umhr/HardwareWatchdogTimer/blog/PXL_20220502_052127613.jpg

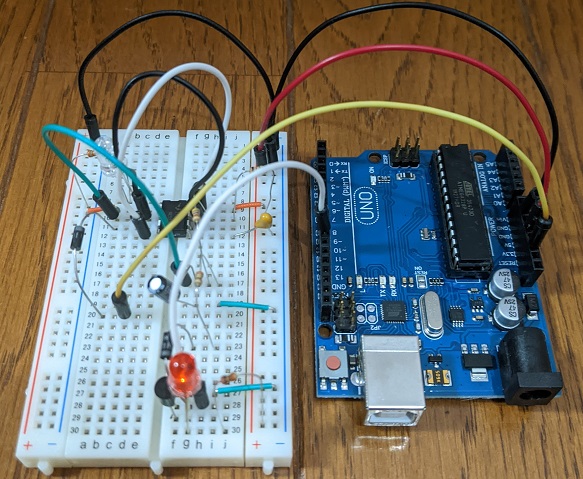
blog/PXL_20220502_052127613.jpg
