umhr/HardwareWatchdogTimer/blog/20220518_112517.png

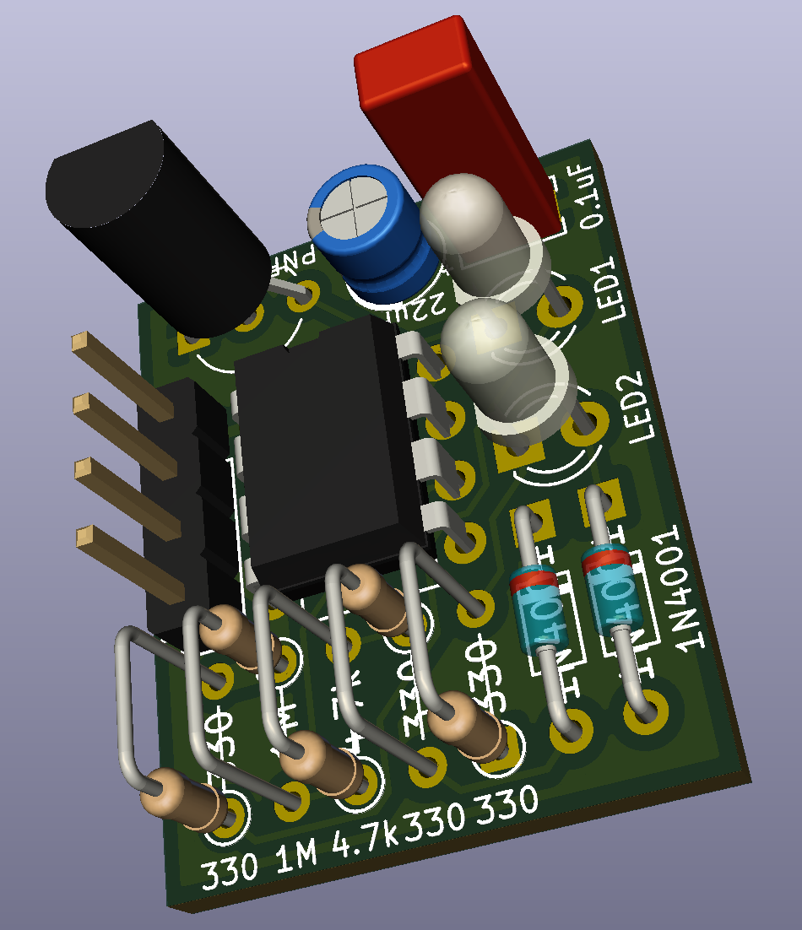
blog/20220518_112517.png
