umhr/HardwareWatchdogTimer/blog/20220518_112225.png

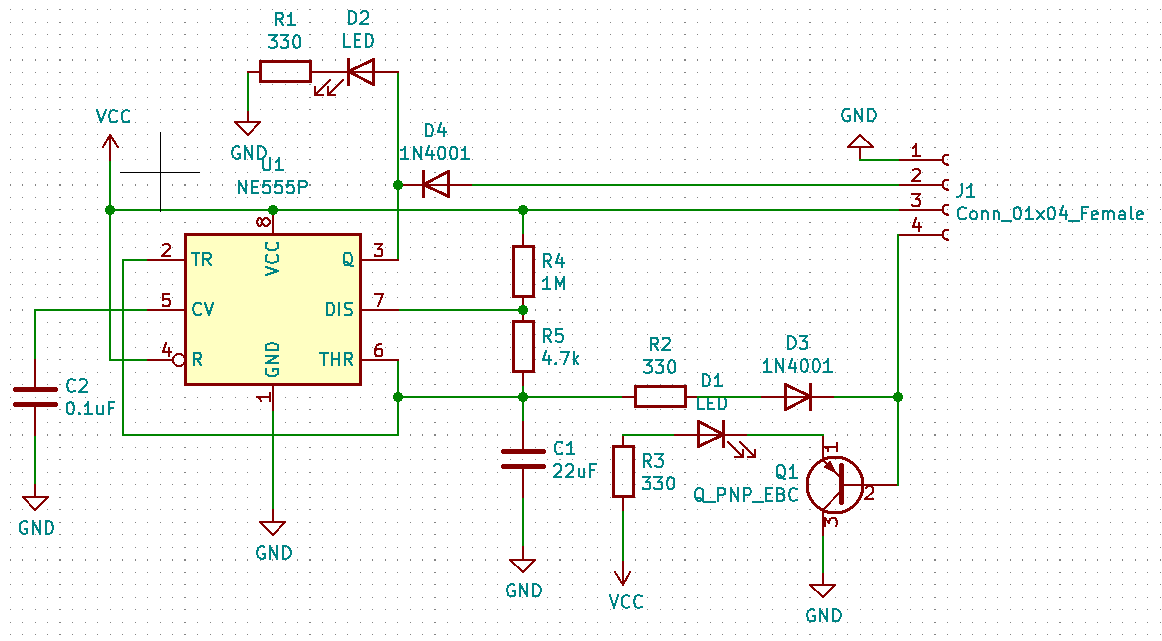
blog/20220518_112225.png
