umhr/HardwareWatchdogTimer/blog/20220518_112425.png

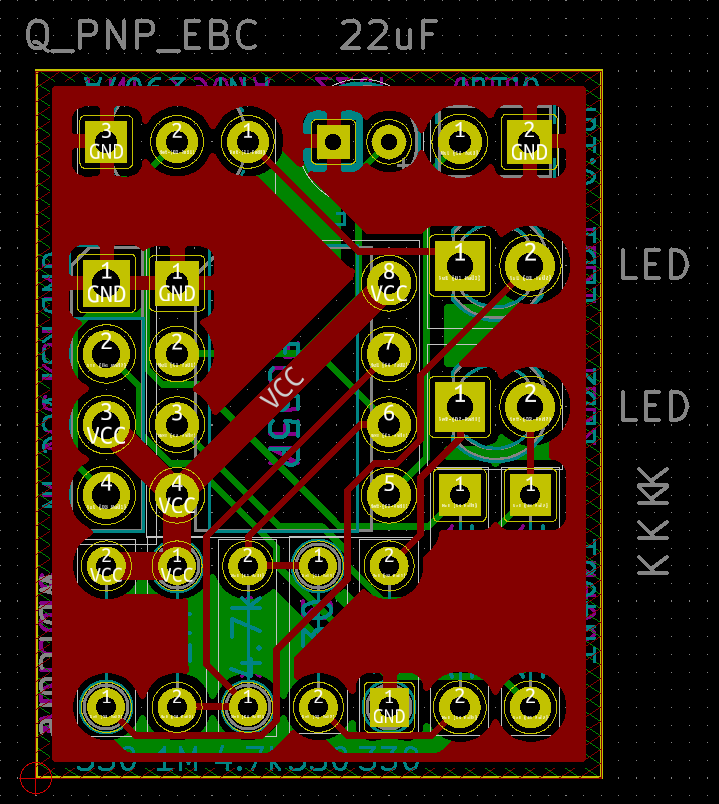
blog/20220518_112425.png
