umhr/HardwareWatchdogTimer/fritzing/wdt_ブレッドボード.png

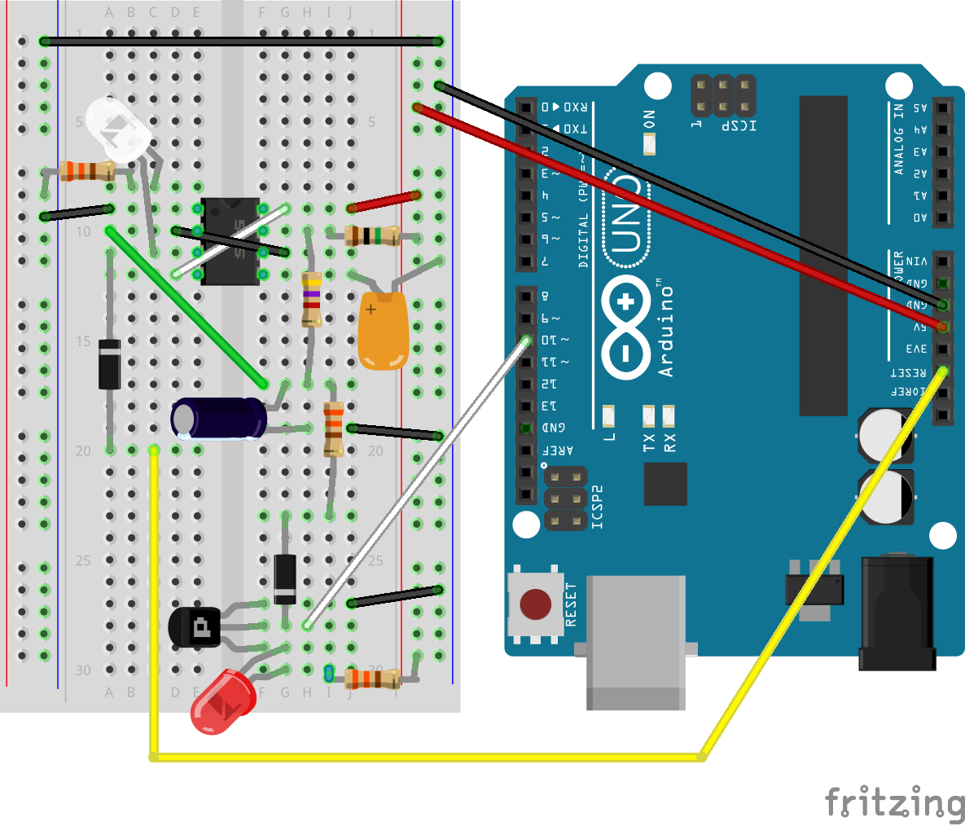
fritzing/wdt_ブレッドボード.png
