umhr/HardwareWatchdogTimer/fritzing/wdt_回路図.png

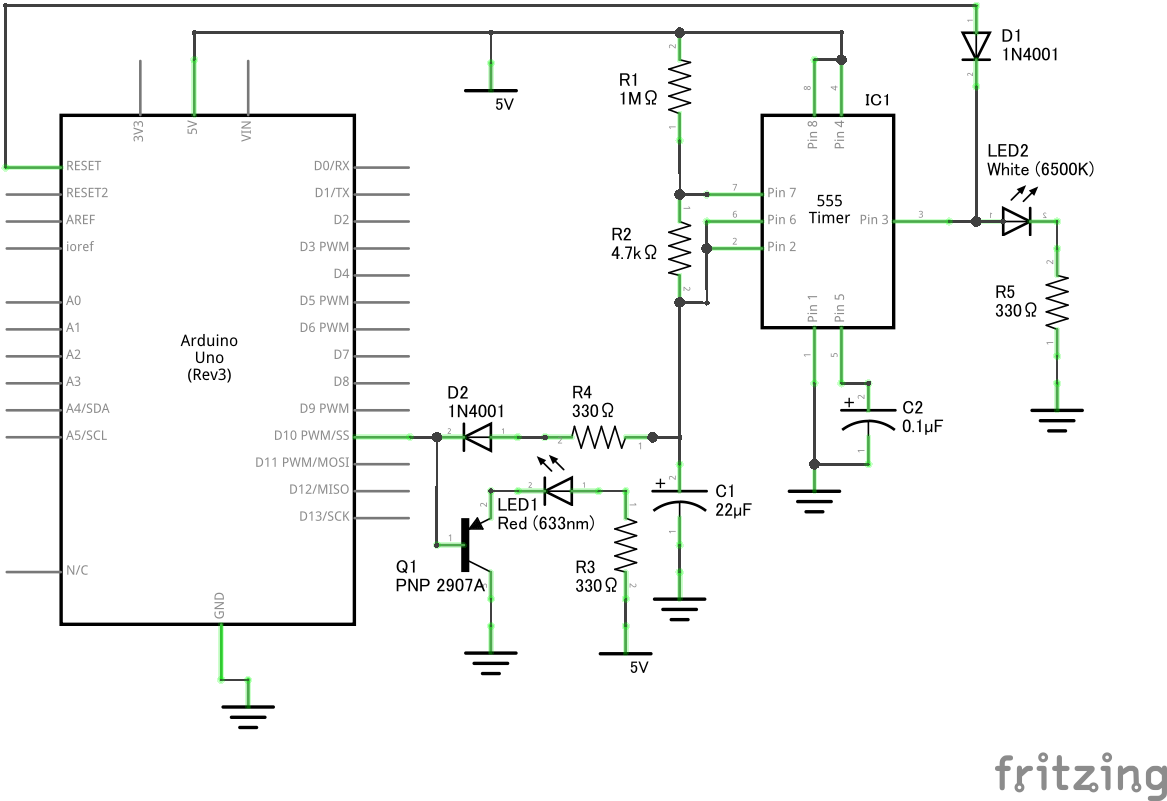
fritzing/wdt_回路図.png
