umhr/HardwareWatchdogTimer/fritzing/wdtmini_ブレッドボード.png

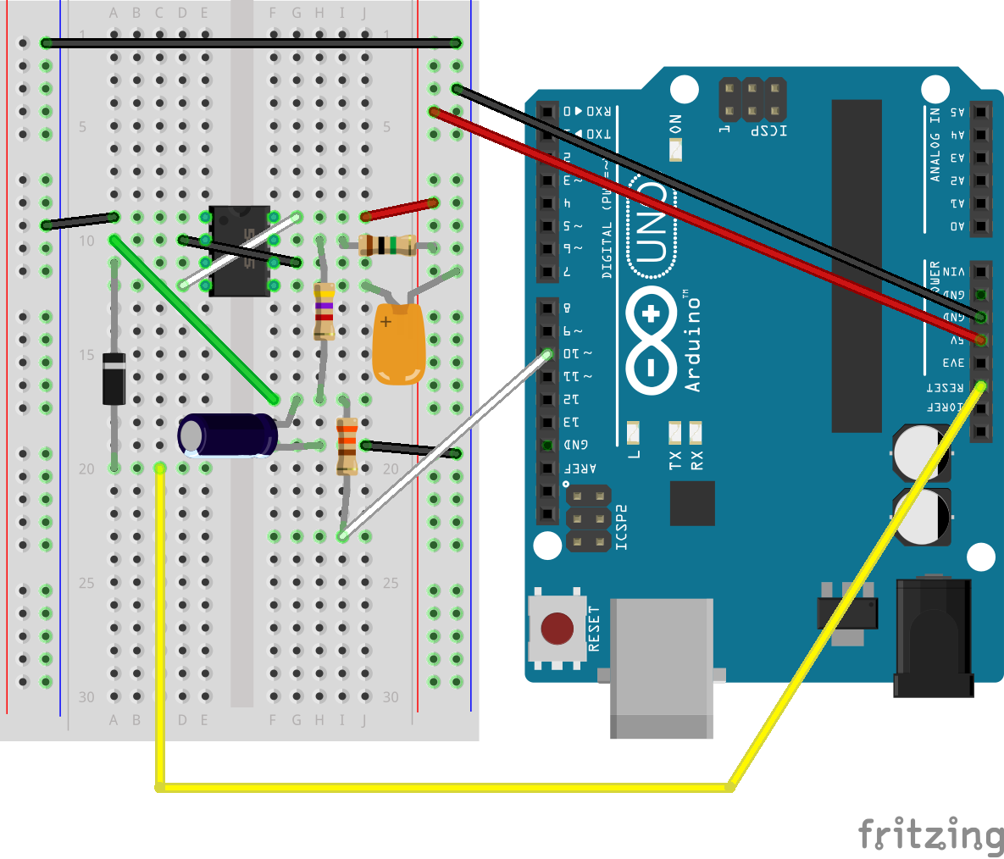
fritzing/wdtmini_ブレッドボード.png
