umhr/HardwareWatchdogTimer/fritzing/wdtmini_回路図.png

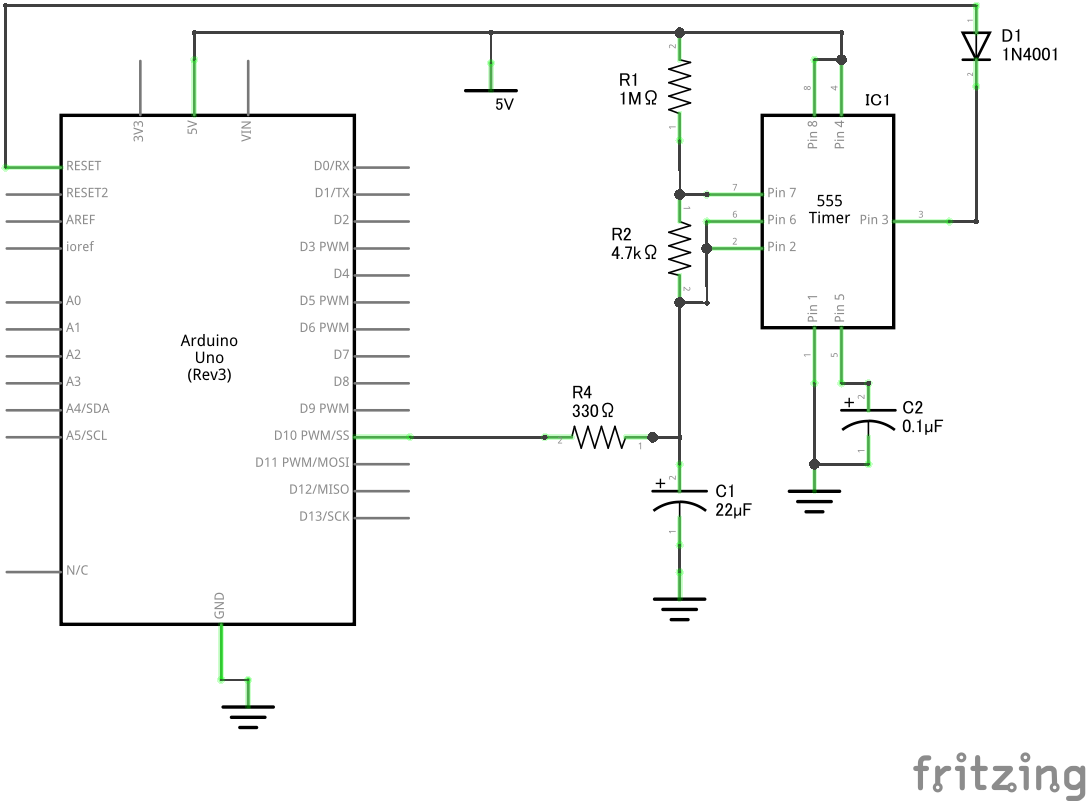
fritzing/wdtmini_回路図.png
