umhr/HardwareWatchdogTimer/(list of files, drawings)

Other design files:
fritzing/wdt.fzz
fritzing/wdtmini.fzz
