umhr/HardwareWatchdogTimer/wdtcore/wdtcore.kicad_pcb

## KiCad design wdtcore/wdtcore.kicad_pcb (2022-05-18)

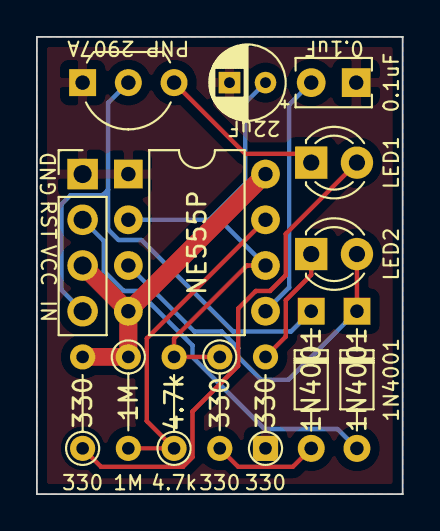
[picture p12: board wdtcore.kicad_pcb from above]

Board: 2 copper layers, 20.3 x 25.4 mm, 14 parts (0 on the bottom side), 12 nets.

Parts:
0.1uF: 0.1uF; C_Rect_L4.0mm_W2.5mm_P2.50mm
1M: 1M; R_Axial_DIN0204_L3.6mm_D1.6mm_P5.08mm_Vertical
1N4001, 1N4001#2: 1N4001; D_DO-34_SOD68_P7.62mm_Horizontal
4.7k: 4.7k; R_Axial_DIN0204_L3.6mm_D1.6mm_P5.08mm_Vertical
22uF: 22uF; CP_Radial_D4.0mm_P2.00mm
330, 330#2, 330#3: 330; R_Axial_DIN0204_L3.6mm_D1.6mm_P5.08mm_Vertical
GND: WDTcore; PinHeader_1x04_P2.54mm_Vertical
LED1, LED2: LED; LED_D3.0mm_Clear
NE555P: WDTcore; DIP-8_W7.62mm
PNP 2907A: Q_PNP_EBC; TO-92L_Inline_Wide

Connections:
GND: 0.1uF.2, 22uF.2, 330#3.1, GND.1, NE555P.1, PNP 2907A.3
unnamed: 4.7k.2, 22uF.1, 330#2.1, NE555P.2, NE555P.6
unnamed: 0.1uF.1, NE555P.5
unnamed: LED1.1, PNP 2907A.1
unnamed: 330.1, LED1.2
unnamed: 330#3.2, LED2.1
unnamed: 1N4001.1, LED2.2, NE555P.3
unnamed: 1N4001#2.1, GND.4, PNP 2907A.2
unnamed: 1N4001#2.2, 330#2.2
unnamed: 1N4001.2, GND.2
unnamed: 1M.2, 4.7k.1, NE555P.7
VCC: 1M.1, 330.2, GND.3, NE555P.4, NE555P.8
